barabashsr/RC_cart/kicad/reciever/reciever.kicad_pcb

## KiCad design relay_unit.kicad_sch


Parts:
J2: USB_C_Receptacle
U1: (no value)

Connections:
unnamed: J2.A1 (GND), J2.A12 (GND), J2.B1 (GND), J2.B12 (GND), J2.SH (SHIELD), U1.26 (GND)
unnamed: J2.A4 (VBUS), J2.A9 (VBUS), J2.B4 (VBUS), J2.B9 (VBUS), U1.23 (VBUS)
unnamed: J2.A6 (D+), J2.B6 (D+), U1.25 (D+)
unnamed: J2.A7 (D-), J2.B7 (D-), U1.24 (D-)
