barabashsr/RC_cart/(commit log)

2026-05-29 initial commit. ready to test
    [partitions.csv]
2026-05-30 rc connection is working. need to fix OLED communication
    [cart_config.h, display.h, engine.c, engine.h, main.c, rc_input.c, rc_input.h, safety.c]
2026-05-31 oled fixed, need to fix servo jumps - duty cicle is not cosistent
    [display.c, display.h, main.c, servo.c, servo.h]
2026-05-31 GPIO aupdated, kicad project created
    [reciever.kicad_pcb, reciever.kicad_sch]
2026-06-01 throttle servo behaves as expected, brake servo goes all the way and does not come back
    [reciever.kicad_sch]
2026-06-01 jerks fixed. need to fix the range
    [cart_config.h, rc_input.c, servo.c]
2026-06-01 calibration applied
2026-06-01 calibration fixed. servos seem to work
    [calibration.c, cart_config.h, main.c, servo.c]
2026-06-08 steering almost fixed. sluggish
    [cart_config.h, pcnt_tracker.c, rmt_pulse_gen.c, servo.c, steering.c]
2026-06-08 steering position errors
2026-06-09 steering works ok. driver settings need to be udjusted and alligned with the config
